isaacgengg/Optical-Sensing-Device/hardware/enclosure/optical-module-bottom.png

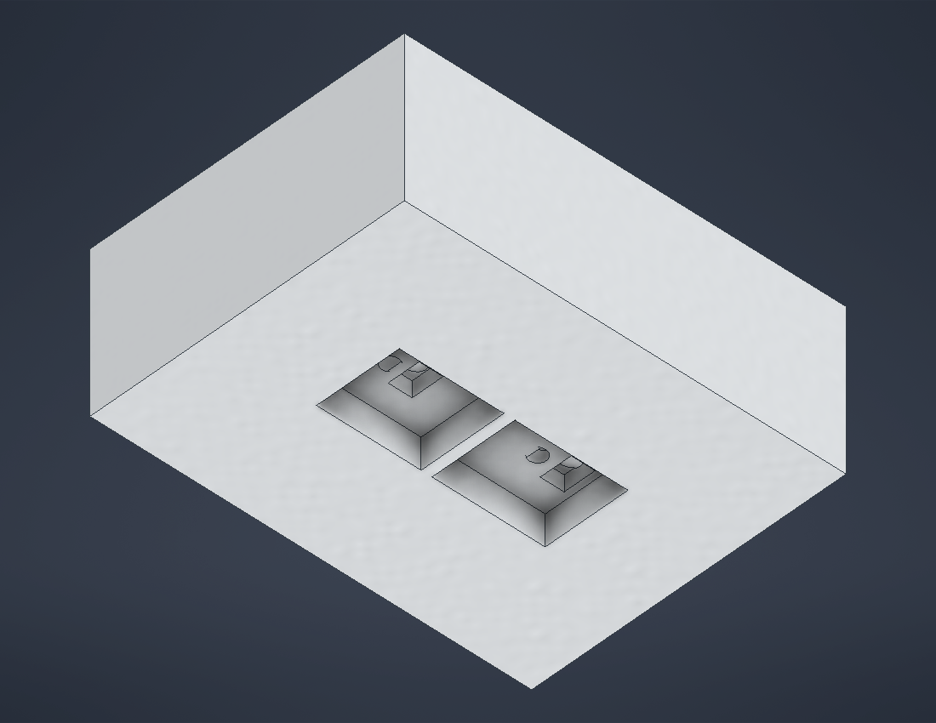
hardware/enclosure/optical-module-bottom.png
