isaacgengg/Optical-Sensing-Device/hardware/enclosure/optical-module.png

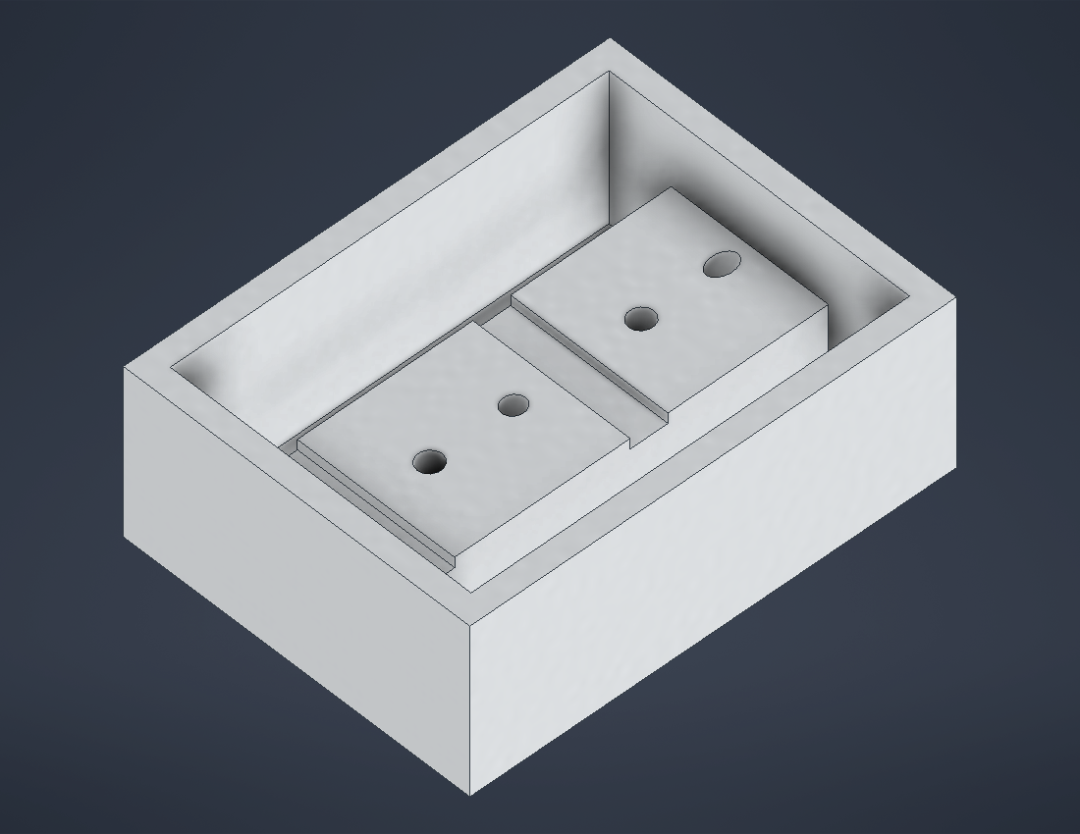
hardware/enclosure/optical-module.png
