isaacgengg/Optical-Sensing-Device/hardware/enclosure/Electronics Assembly.step

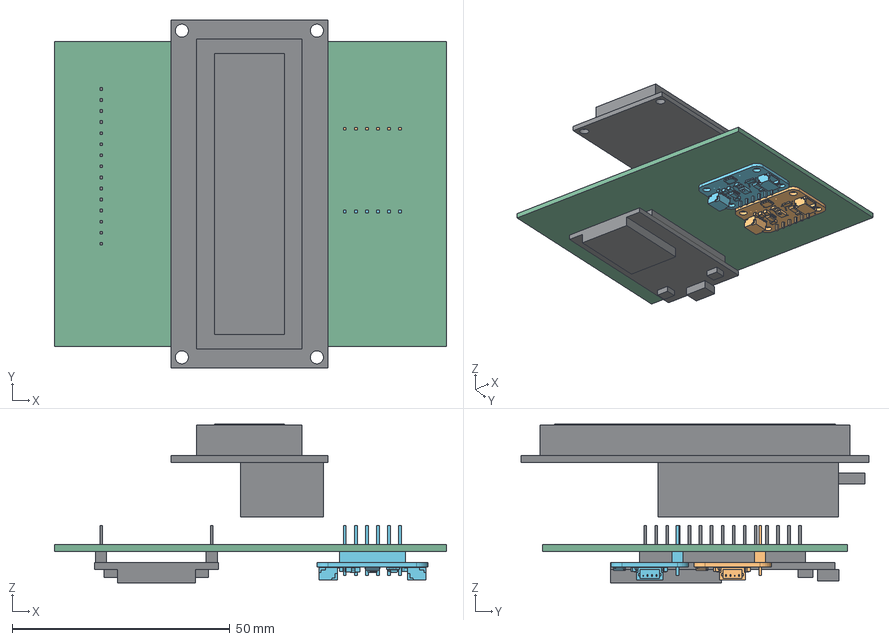
[picture p5: CAD file, 2026-11-13]
hardware/enclosure/Electronics Assembly.step
90.0 x 80.0 x 36.5 mm
TCS3448_test_color
TCS3448_test_color_header
AS7343_control_proxy
AS7343_control_proxy_header
ESP32
LCD
Perfboard_outline_reference
