isaacgengg/Optical-Sensing-Device/hardware/enclosure/exports/as-built/Enclosure Color.step

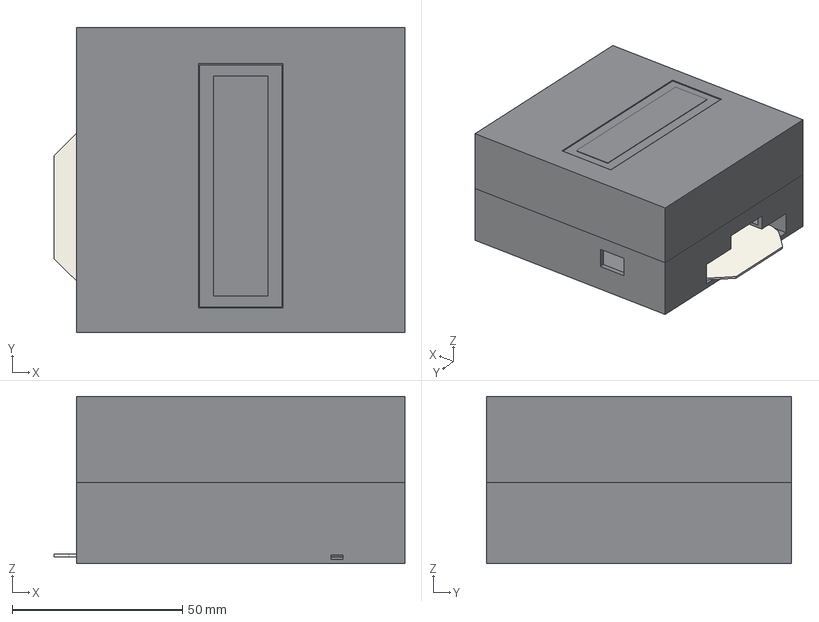
[picture p6: CAD file, 2026-11-13]
hardware/enclosure/exports/as-built/Enclosure Color.step
103.1 x 89.5 x 49.2 mm
TCS3448_test_color
TCS3448_test_color_header
AS7343_control_proxy
AS7343_control_proxy_header
ESP32
LCD
Perfboard_outline_reference
Enclosure_Base
Optical_Module
Enclosure_Lid
Pouch
