isaacgengg/Optical-Sensing-Device/hardware/enclosure/exports/test-jig/Optical Module d2.0.stl

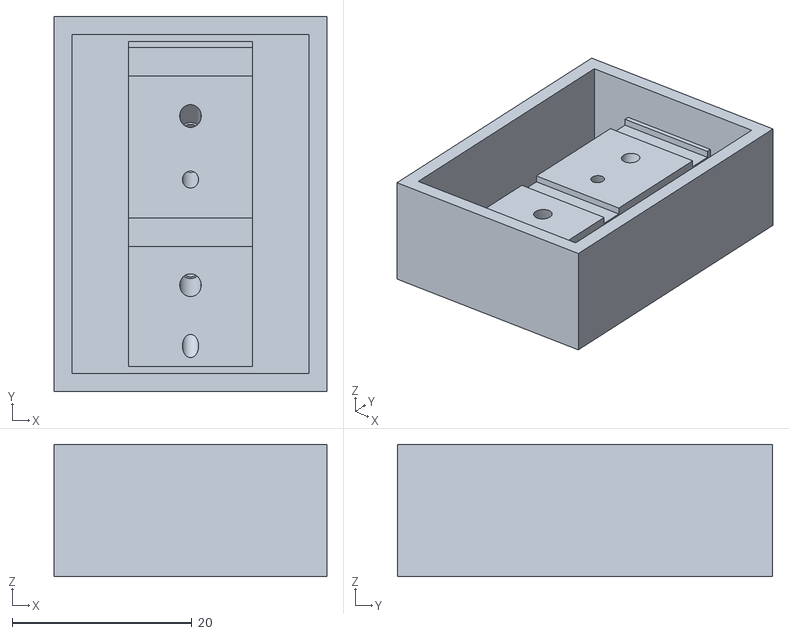
[picture p7: CAD file, 2026-11-13]
hardware/enclosure/exports/test-jig/Optical Module d2.0.stl
30.4 x 41.8 x 14.7
