isaacgengg/Optical-Sensing-Device/hardware/enclosure/reference/ESP32.step

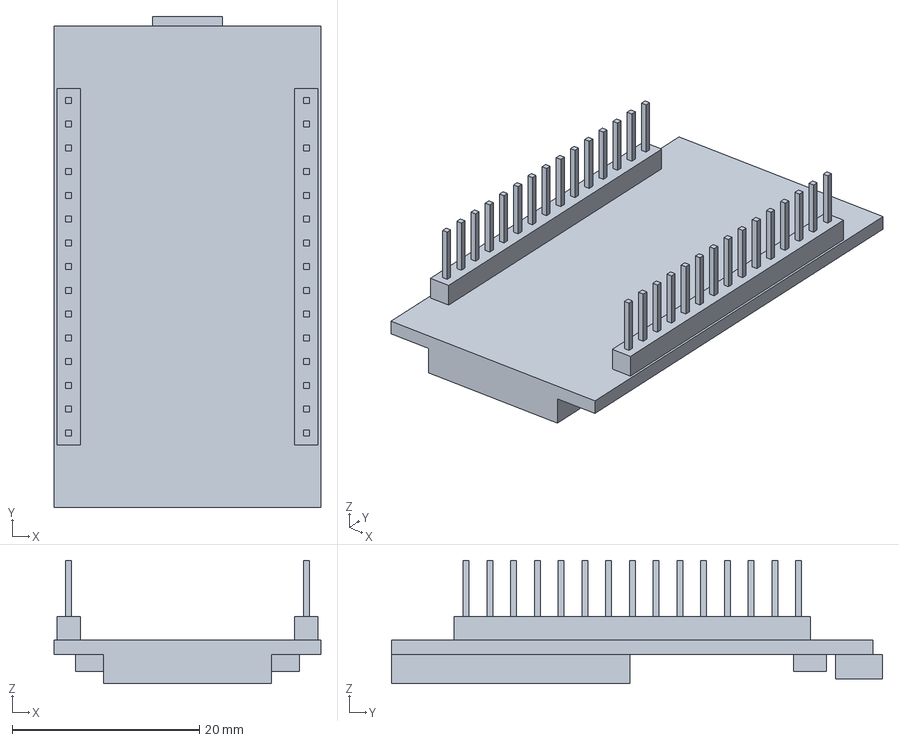
[picture p8: CAD file, 2026-11-13]
hardware/enclosure/reference/ESP32.step
28.5 x 52.5 x 13.2 mm
