isaacgengg/Optical-Sensing-Device/hardware/enclosure/exports/as-built/Enclosure Base.step

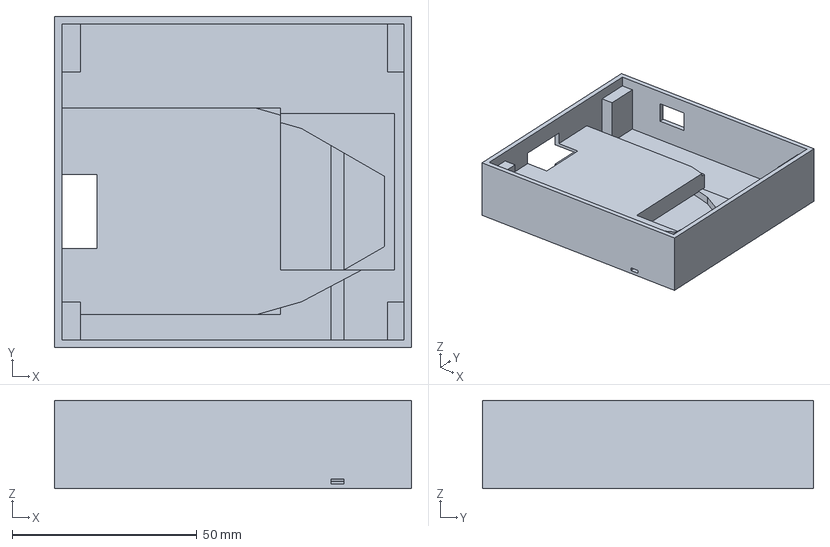
[picture p9: CAD file, 2026-11-13]
hardware/enclosure/exports/as-built/Enclosure Base.step
96.5 x 89.5 x 23.9 mm
