isaacgengg/Optical-Sensing-Device/hardware/enclosure/exports/as-built/Optical Module d1.6.step

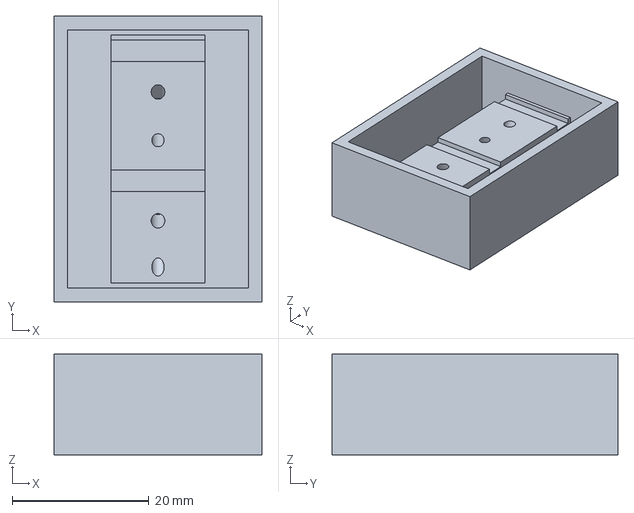
[picture p10: CAD file, 2026-11-13]
hardware/enclosure/exports/as-built/Optical Module d1.6.step
30.4 x 41.8 x 14.7 mm
