isaacgengg/Optical-Sensing-Device/hardware/enclosure/exports/test-jig/Optical Module d1.6.stl

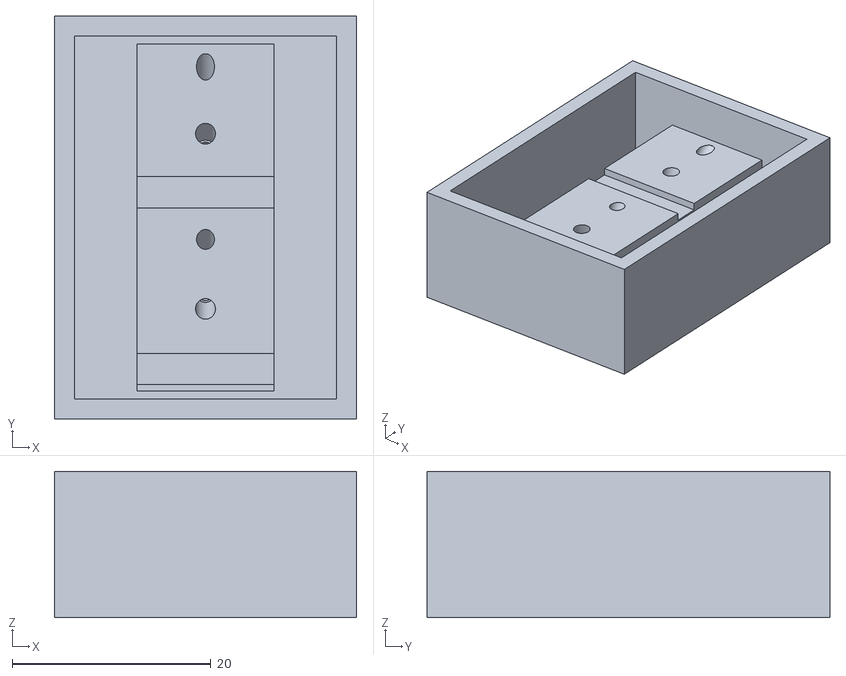
[picture p11: CAD file, 2026-11-12]
hardware/enclosure/exports/test-jig/Optical Module d1.6.stl
30.4 x 40.6 x 14.7
