isaacgengg/Optical-Sensing-Device/hardware/enclosure/exports/test-jig/Test Sled.step

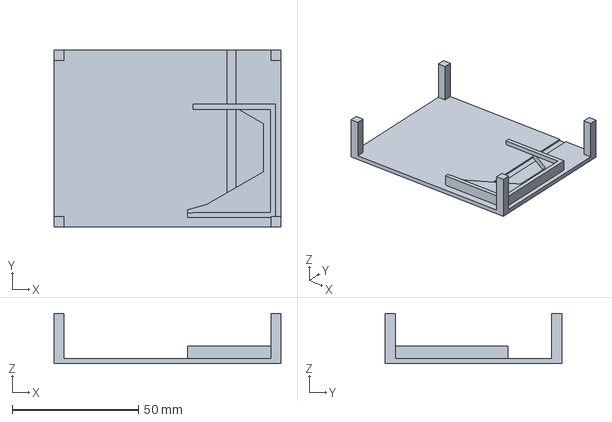
[picture p12: CAD file, 2026-11-12]
hardware/enclosure/exports/test-jig/Test Sled.step
90.0 x 70.0 x 19.9 mm
