isaacgengg/Optical-Sensing-Device/(list of files, cad)

Other CAD files:
hardware/enclosure/exports/test-jig/Optical Module d2.5.step
hardware/enclosure/exports/test-jig/Optical Module d1.2.step
hardware/enclosure/exports/as-built/Optical Module d2.0.step
hardware/enclosure/Electronics Assembly.iam
hardware/enclosure/Electronics/Perfboard 70x90.ipt
hardware/enclosure/Electronics/Wiring.ipt
hardware/enclosure/Enclosure/Enclosure Base.ipt
hardware/enclosure/Enclosure/Enclosure Lid.ipt
hardware/enclosure/Enclosure/Optical Module.ipt
hardware/enclosure/Purchased Parts/Adafruit/6525 TCS3448 Light Color Sensor/0603-NO.ipt
hardware/enclosure/Purchased Parts/Adafruit/6525 TCS3448 Light Color Sensor/0805-NO.ipt
hardware/enclosure/Purchased Parts/Adafruit/6525 TCS3448 Light Color Sensor/1-soldermask.ipt
hardware/enclosure/Purchased Parts/Adafruit/6525 TCS3448 Light Color Sensor/Packages.iam
hardware/enclosure/Purchased Parts/Adafruit/6525 TCS3448 Light Color Sensor/RESPACK_4X0603.ipt
hardware/enclosure/Purchased Parts/Adafruit/6525 TCS3448 Light Color Sensor/SOT23-6 (1).ipt
hardware/enclosure/Purchased Parts/Adafruit/6525 TCS3448 Light Color Sensor/SOT23-6.ipt
hardware/enclosure/Test Jig/Optical Module d1.6.ipt
hardware/enclosure/Test Jig/Optical Module d2.0.ipt
hardware/enclosure/Test Strips/LFA Strip (bare).ipt
hardware/enclosure/exports/as-built/Optical Module d1.6.stl
hardware/enclosure/exports/test-jig/Optical Module d2.5.stl
hardware/enclosure/exports/test-jig/Test Sled.stl
