isaacgengg/Optical-Sensing-Device/firmware/main/board.h

// Pin and bus definitions for the board. Must match hardware/ schematic.
#pragma once

// TODO(team): all values are placeholders. Match them to the schematic.
#define BOARD_I2C_PORT   0
#define BOARD_I2C_SDA    21
#define BOARD_I2C_SCL    22
#define BOARD_I2C_HZ     400000
#define BOARD_LED_GPIO   4
#define BOARD_SENSOR_I2C_ADDR 0x59   // TCS3448, fixed (datasheet table 8)
