isaacgengg/Optical-Sensing-Device/(commit log)

2026-10-02 isaac/Add keyboard input for selecting test mode (#2)
    Measurements now start from user input instead of a fixed timer, and
    each one runs in a chosen mode: lateral flow or colorimetric.
    - Add command_source port (core/ports) and console_input adapter that
    reads 'l'/'c' from the serial console, a stand-in for the keypad.
    - Add strip_mode_t to the domain; results carry the mode and the log
    sink prints it. Both modes still share the placeholder analysis.
    - Replace the fixed-interval demo loop in main.c and remove
    DC_MEASURE_INTERVAL_MS.
    - Raise the measurement task stack from 4 KB to 8 KB; it overflowed on
    the first measurement.
    - Document QEMU usage, monitor exit ke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
    [console_input.c, console_input.h, main.c]
2026-10-02 isaac/lateral-flow-analysis (#3)
    * initial changes
    * new mock analysis test cases
2026-10-20 Show live ESP32 results in the dashboard over Bluetooth (#7)
    * Show live ESP32 results in the dashboard over Bluetooth
    The dashboard can now connect to the reader with Web Bluetooth and add
    each result to the history as it arrives. No server or backend: the
    browser talks to the ESP32 directly.
    Dashboard (visualization/index.html):
    - Connect/Disconnect button and live status badge.
    - decodeResult() checks the 8-byte v0 payload length and version, then
    hands the result to the existing handleResult().
    - History gets a Source column (Device or Simulated). The simulate
    button still works with no device.
    - Clear messages for unsupported browsers, non-secure pages, and the
    Linux Chrome flag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
2026-10-29 Add TCS3448 spectral sensor driver (#6)
    * Add TCS3448 spectral sensor driver
    Replaces the AS7341 placeholder skeleton with a working driver for the
    ams OSRAM TCS3448, written from datasheet DS001121 v1-01.
    - init: checks the ID (0x81, register bank 1), powers on, selects
    18-channel auto-SMUX, sets gain 256x. Reserved bits are preserved.
    - set_integration_ms: fixed ASTEP 599 (1.668 ms/step), ms -> ATIME,
    1-427 ms. ASTEP is written as one low-then-high burst.
    - read: starts a fresh measurement, polls AVALID with a timeout, burst
    reads ASTATUS + 18 channels, stops. Returns 14 channels in wavelength
    order (F1..F8, FZ, FY, FXL, NIR, VIS, FD); saturation is an error.
    - i2c_bus: add i2c_b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
2026-11-03 Fix TCS3448 read timeout and set lateral flow to competitive (#10)
    At CONFIG_FREERTOS_HZ=100, pdMS_TO_TICKS(5) truncates to 0 ticks, so the
    TCS3448 data-ready poll never waited and every read returned
    ESP_ERR_TIMEOUT. Round delays up to whole ticks in the timebase so every
    caller gets at least the delay it asked for.
    Lateral flow is confirmed competitive (C+T = negative, C only = positive).
2026-11-03 Match colorimetric pads to reference colors (#12)
    Replace the placeholder brightness threshold with color matching: divide
    the averaged reading by a white reference to get per-channel reflectance,
    then pick the nearest reference curve (RMS distance). Nothing within
    max_distance gives STRIP_INVALID.
    The white reference, pad colors and distance limit live in
    firmware/main/color_refs.h, with made-up values for now. The log sink now
    prints the matched color and the raw and reflectance channels, paste-ready
    for color_refs.h, so real references can be measured in the jig.
2026-11-03 Add cross-platform setup guide for building and flashing (#13)
    docs/setup.md covers Linux, macOS and Windows: build in the espressif/idf
    Docker image, flash and monitor from the host with esptool (Docker Desktop
    can't pass USB through on Mac and Windows). Each build (tcs3448, mock, ble)
    gets its own build dir and sdkconfig, so switching no longer needs deleting
    firmware/sdkconfig.
    Add firmware/sdkconfig.tcs3448 and use it in CI instead of a /tmp file.
    Point README and the dashboard docs at the guide.
2026-11-05 isaac/i2c reset on rety (#16)
2026-11-07 isaac/Restore TCS3448 auto_smux before every read + color refs (#17)
    * Restore TCS3448 auto_smux before every read
    If the chip resets after init (brownout, loose wire), CFG20 auto_smux
    falls back to 6-channel mode and 8 of the 14 channels silently read 0.
    Check it before each measurement, warn, and rewrite it if lost.
    * Use measured color references and log the matched color
    Replace the made-up white and pad references with readings from the
    cardboard-box rig: white card, 4 red and 3 green test strips. Map them
    to placeholder results: white = control (negative), red = fentanyl,
    green = cocaine (positive).
    Each reference now carries a color name, logged as color= next to match=.
2026-11-10 isaac/Add Inventor enclosure, electronics layout and wiring (#18)
    Inventor 2027 project in hardware/enclosure with:
    - Electronics Assembly: 70x90 perf board, Hosyond 30-pin ESP32, Adafruit
    TCS3448 breakout (official STEP) on its header, 1602 I2C LCD, and the
    point-to-point wiring (I2C on D21/D22, 3V3, 5V, GND).
    - Enclosure Assembly: base with a rear-entry pouch tunnel and tapered stop,
    a separate optical module (pad window, light chamber, sensor aperture,
    TCS3448 pocket, sleeved 45 deg LED tunnels with diffuser recesses), and a
    lid with the LCD window and board clamps. The pouch slides on constraints
    (Insertion 0-95 mm) and is checked for collisions along its travel.
    - scripts/ t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
2026-11-12 Read LFA test and control zones with TCS3448 and AS7343 (#19)
    * Add dual-sensor LFA with TCS test and AS7343 control zones
    * Document dual-sensor setup and existing workflow compatibility
    ---------
2026-11-12 isaac/Add optional sensor onboard white LEDs with --sensor-leds build flag (#20)
    Both Adafruit breakouts (TCS3448, AS7343) drive their white LED from the
    chip's LED register (0xCD). The drivers get *_set_led(on, mA) and turn the
    LED off at init. With CONFIG_DC_SENSOR_LEDS, main wires one illuminator that
    switches the GPIO LED and both white LEDs together; a missing AS7343 is
    skipped so colorimetric still works.
    tools/run.py: --sensor-leds layers sdkconfig.sensor_leds into a separate
    build-<name>-leds dir; --sensor-led-ma N (4-258, default 20) sets the
    current.
2026-11-12 isaac/Add STEP export script for viewing the enclosure without Inventor (#21)
    scripts/export_step.ps1 exports Enclosure Assembly and Electronics Assembly
    to STEP (AP214) next to the .iam files through Inventor's STEP translator.
    README points non-Inventor users to 3dviewer.net / FreeCAD.
2026-11-12 Isaac/dual sensor electronics (#22)
    * Re-lay out electronics for the dual-sensor LFA reader
    Matches the electronics assembly to PR #19's two sensors and to the
    soldered board:
    - ESP32 moved to columns 1 and 11, rows 7-21 (column 0 and rows 22-23
    free), as soldered.
    - TCS3448 turned 90 deg with its header along row 14, still centred on the
    pouch's colorimetric pad.
    - AS7343 added the same way round with its header along row 7, edge to edge
    with the TCS3448 (sensors 17.8 mm apart). Adafruit has no 3D model of the
    AS7343 breakout yet; its board file matches the TCS3448's outline, holes,
    sensor position and pinout, so it reuses that model.
    - Wiring regenerated with the real board's co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
2026-11-13 Adapt enclosure optics to photographed sensor orientation
